DisasterAreaDesigns/boostPCB/README.md

# boostPCB

Documentation for the Disaster Area Designs DIY Boost Kit PCB

.sch and .brd are EAGLE CAD files

gerbers folder has 274-X gerber files for making your own boards at commercial PCB fabs

BOM and schematic in PDF format
