DisasterAreaDesigns/boostPCB/Boost Kit.brd

## EAGLE design Boost Kit.brd (2022-02-17)

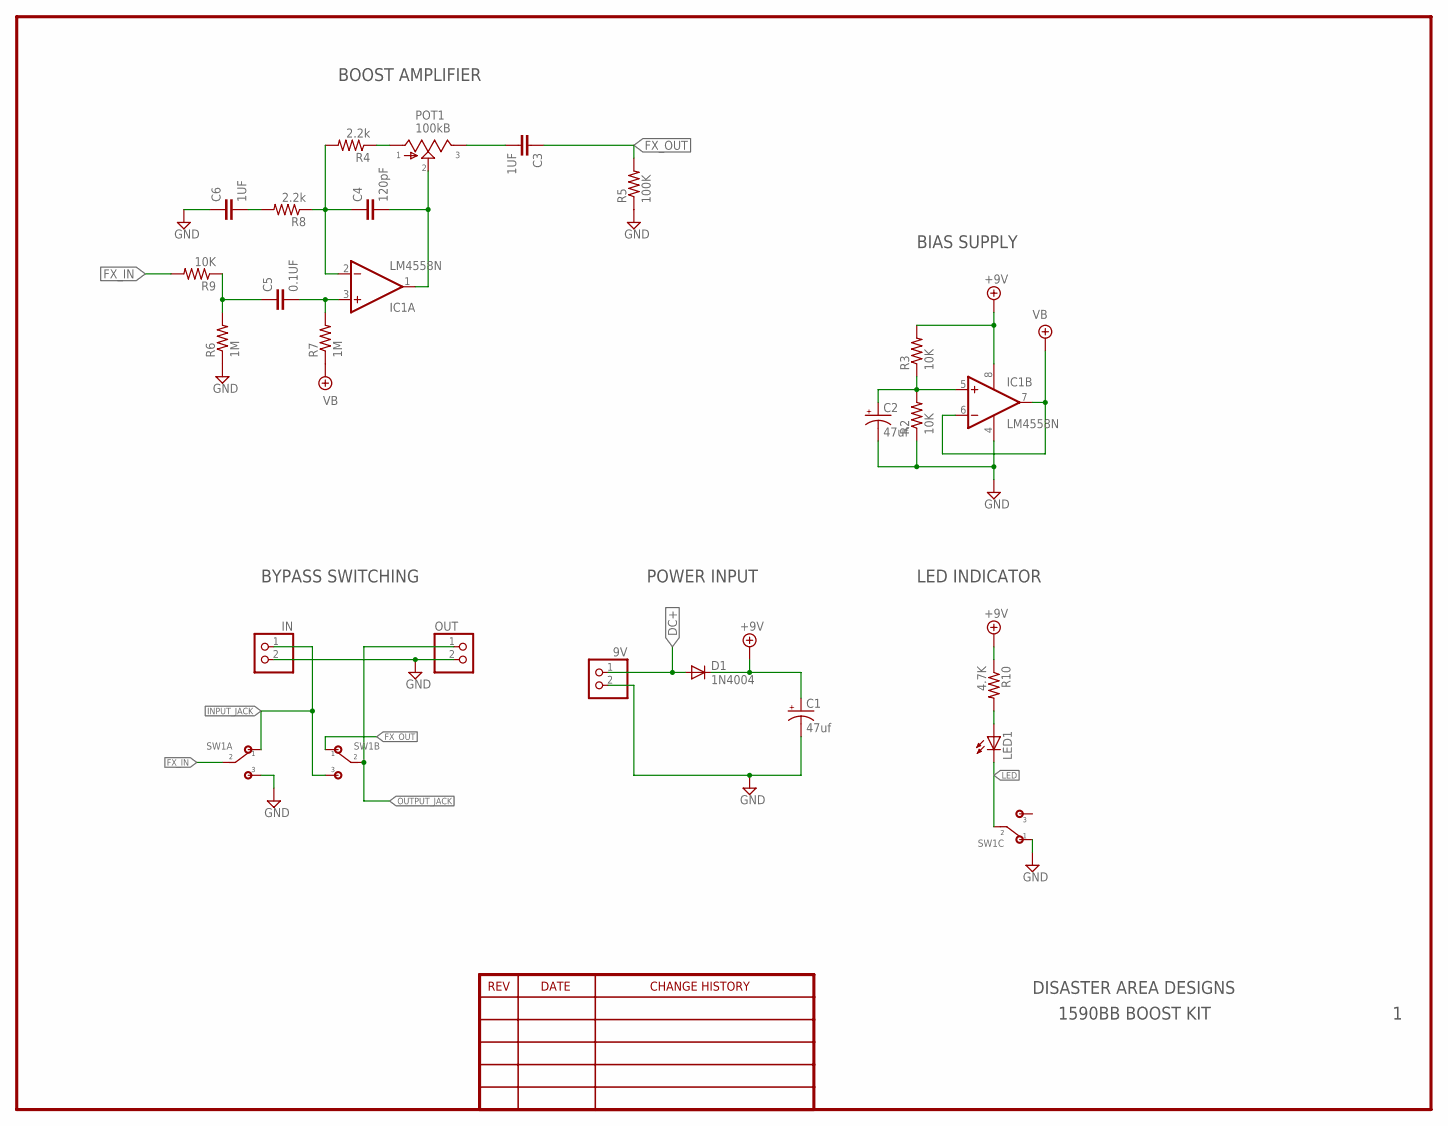
[picture p2: schematic Boost Kit.sch]

Parts:
9V: PINHD-1X2; 1X02
C1, C2: 47uf; E2,5-6
C3, C6: 1UF; 072X035
C4: 120pF; 072X035
C5: 0.1UF; 072X035
D1: 1N4004; DO41-10
IC1: LM4558N; DIL08
IN: PINHD-1X2; 1X02
LED1: LED5MM
OUT: PINHD-1X2; 1X02
POT1: 100kB; 16MM
R2, R3, R9: 10K; R0207/4
R4, R8: 2.2k; R0207/4
R5: 100K; R0207/4
R6, R7: 1M; R0207/4
R10: 4.7K; R0207/4
SW1: 3PDT

Connections:
+9V: C1.+, D1.C, IC1.8 (V+), R3.2, R10.1
DC+: 9V.1, D1.A
FX_IN: R9.2, SW1.A2
FX_IN2: C5.1, R6.2, R9.1
FX_OUT: C3.1, R5.2, SW1.B1
GND: 9V.2, C1.-, C2.-, C6.1, IC1.4 (V-), IN.2, OUT.2, R2.1, R5.1, R6.1, SW1.A3, SW1.C1
INPUT_JACK: IN.1, SW1.A1, SW1.B3
LED: LED1.K (C), SW1.C2
unnamed: LED1.A, R10.2
unnamed: C4.2, IC1.1 (OUT), POT1.2
unnamed: C4.1, IC1.2 (-IN), R4.2, R8.1
unnamed: C6.2, R8.2
unnamed: POT1.1, R4.1
unnamed: C2.+, IC1.5 (+IN), R2.2, R3.1
unnamed: C3.2, POT1.3
unnamed: C5.2, IC1.3 (+IN), R7.2
OUTPUT_JACK: OUT.1, SW1.B2
VB: IC1.6 (-IN), IC1.7 (OUT), R7.1

Notes on the sheet:
1590BB BOOST KIT
DISASTER AREA DESIGNS
BOOST AMPLIFIER
BIAS SUPPLY
BYPASS SWITCHING
POWER INPUT
LED INDICATOR

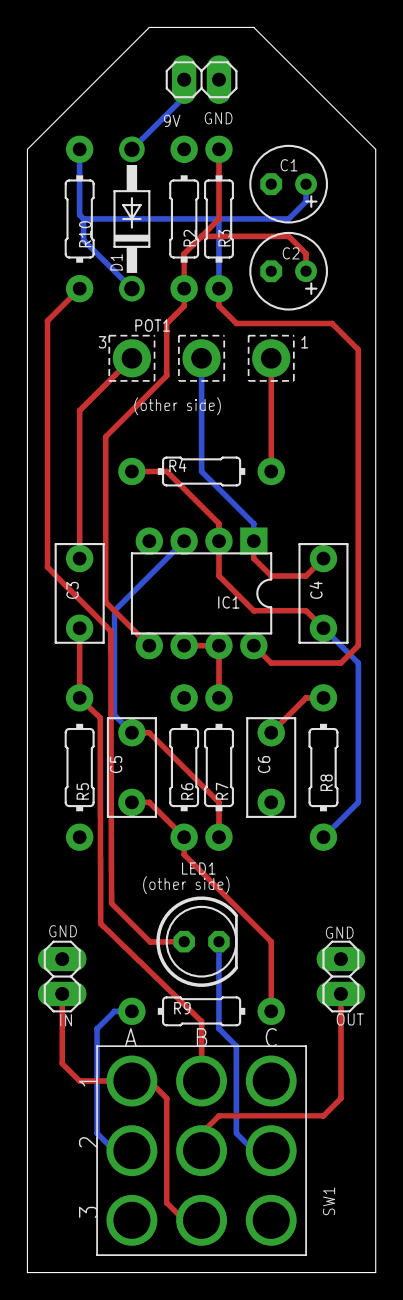
[picture p3: board Boost Kit.brd from above]

Board: 2 copper layers, 25.4 x 90.8 mm, 23 parts (0 on the bottom side), 18 nets.
