DisasterAreaDesigns/boostPCB/(notices)

Notices in the files:
parts and their libraries:
apex-dframes: Copyright (C) 2004, Bob Starr (bobstarr@mindspring.com)
